alphyajitcherian/boost-converter-c2000/assets/efficiency/efficiency_synchronous.png

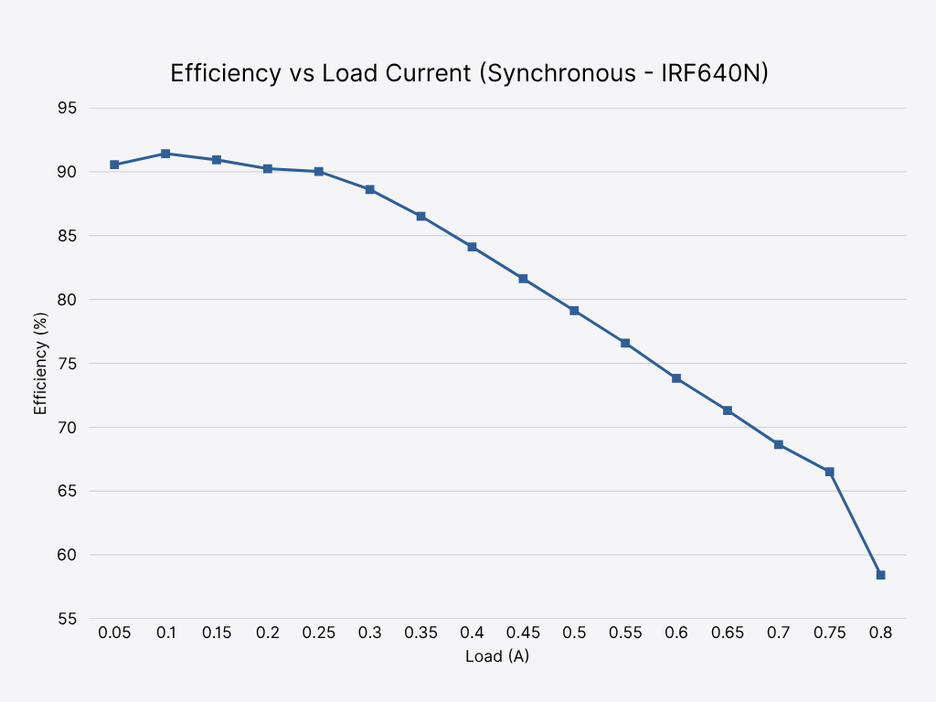
assets/efficiency/efficiency_synchronous.png
