alphyajitcherian/boost-converter-c2000/assets/output_voltage/vout_open-loop_synchronous.png

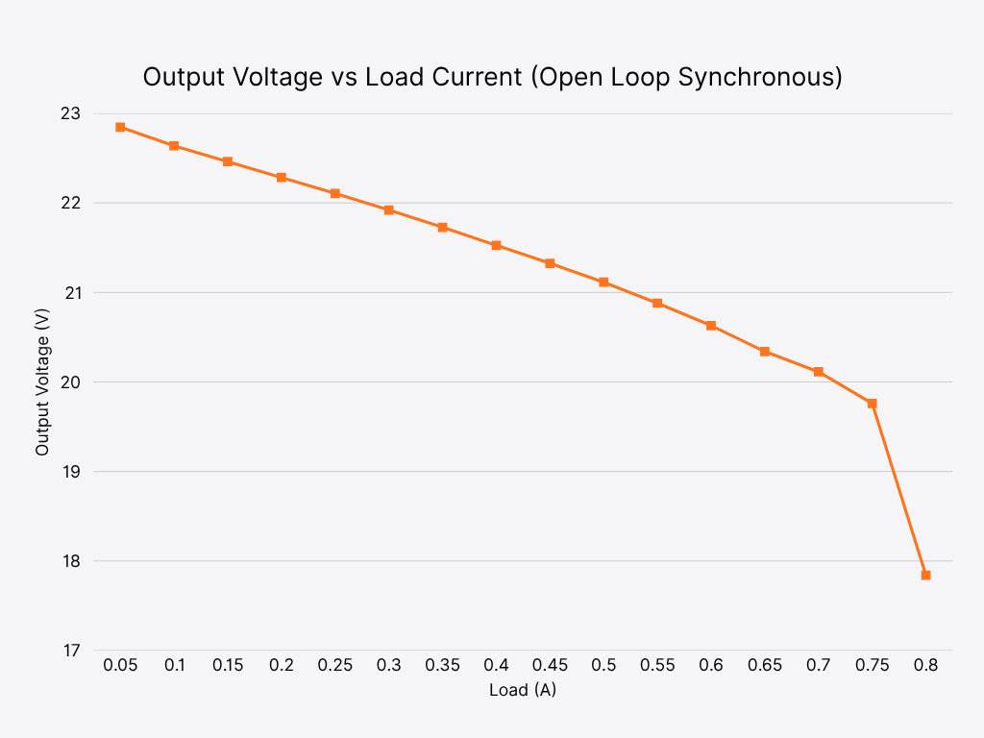
assets/output_voltage/vout_open-loop_synchronous.png
